pabwlc/memristive-dual-agent-circuit/analog_signal_processing_board_pcb_layout_bom.pdf

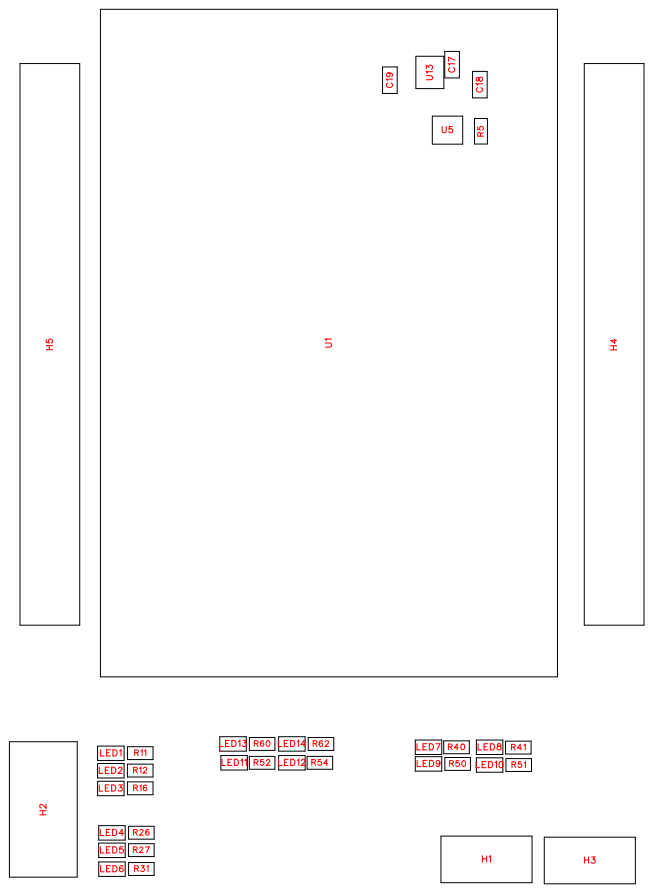
[picture p1: page 1]

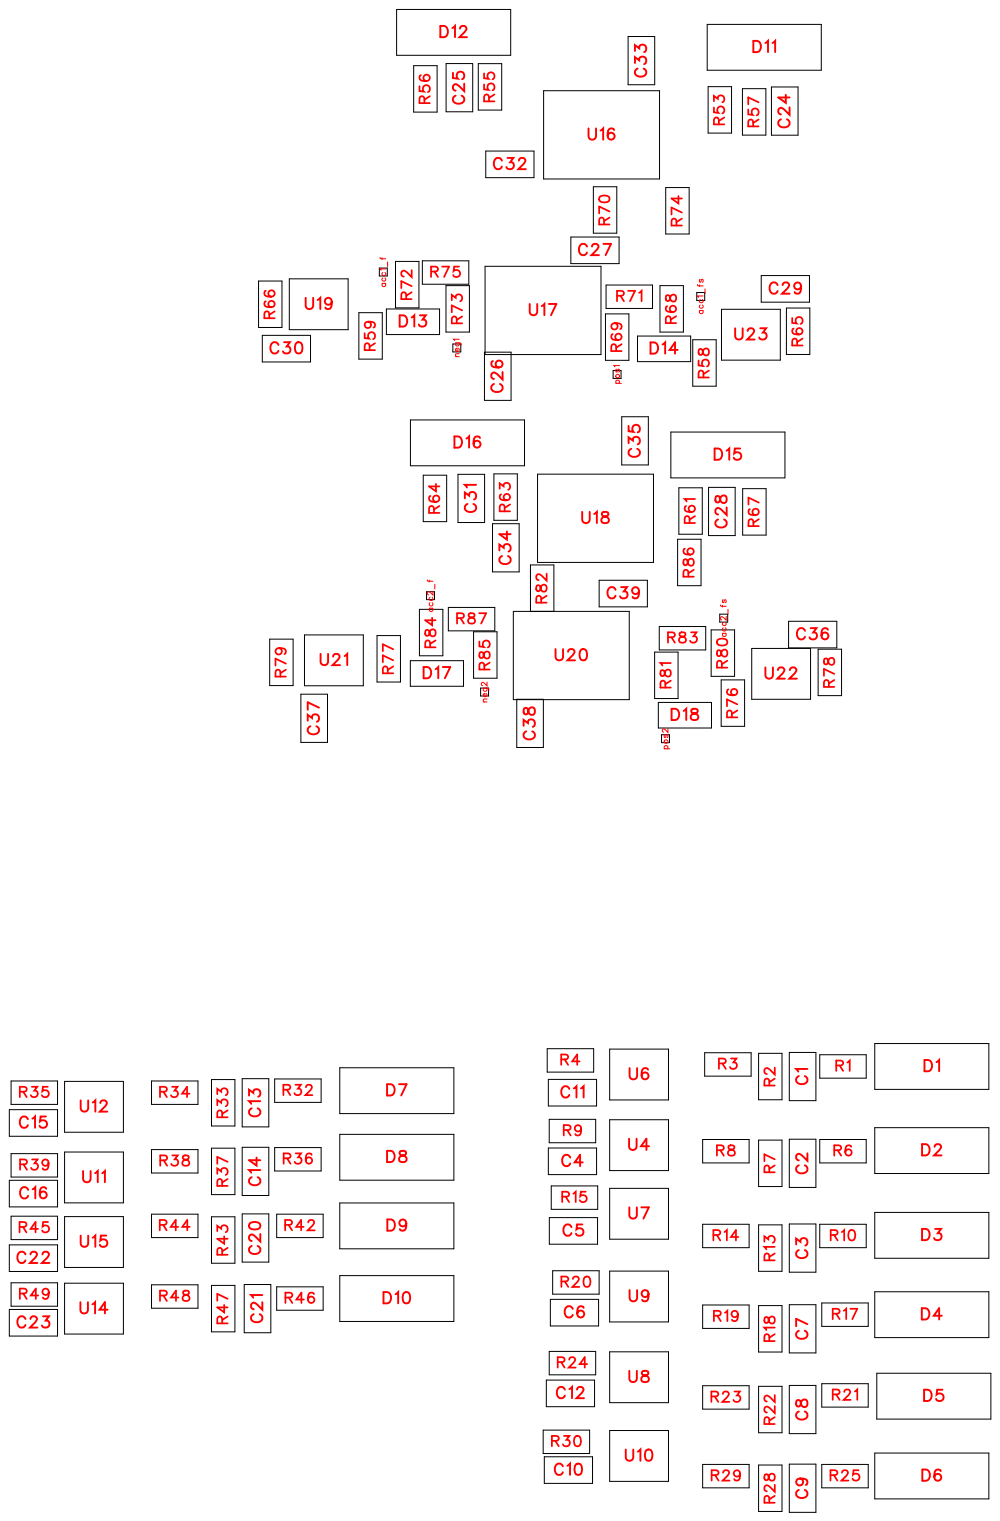
[picture p2: page 2]

No. | Quantity | Comment | Designator | Footprint | Value | Manufacturer Part | Manufacturer | Supplier Part | Supplier
1 | 8 | Test-Point | acc1_f,acc1_fs,acc2_f,acc2 _fs,neg1,neg2,pos1,pos2 | Test-Point-0. 5mm
2 | 10 | 220nF | C1,C2,C3,C7,C8,C9,C13,C 14,C20,C21 | C0603 | 220nF
3 | 14 | 0.1uf | C4,C5,C6,C10,C11,C12,C1 5,C16,C22,C23,C29,C30,C 36,C37 | C0603 | 0.1uf
4 | 3 | 1uf | C17,C18,C19 | C0603 | 1uf
5 | 4 | 470nf | C24,C25,C28,C31 | C0603 | 470nf
6 | 8 | 100nF | C26,C27,C32,C33,C34,C35 ,C38,C39 | C0603 | 100nF
7 | 14 | D_1N4007 | D1,D2,D3,D4,D5,D6,D7,D8, D9,D10,D11,D12,D15,D16 | SMA_1N400 7
8 | 4 | CUS10S30,H 3F | D13,D14,D17,D18 | SOD-323_L1 .8-W1.3-LS2. 5-RD | | CUS10S30,H 3F | TOSHIBA(东 芝) | C146335 | LCSC
9 | 2 | PZ254V-12-8 P | H1,H3 | HDR-TH_8P-P2.54-V-M-R 2-C4-S2.54 | | PZ254V-12-8 P | XFCN(兴飞) | C492421 | LCSC
10 | 1 | HX PZ2.54-3x6P ZZ | H2 | CONN-TH_H X-PZ2.54-3X 6P-ZZ | | HX PZ2.54-3x6P ZZ | hanxia(韩下) | C32713293 | LCSC
11 | 2 | HC-PM254-8 .5H-2x25PZ | H4,H5 | HDR-TH_50 P-P2.54-V-F-R2-C25-S2.5 4-1 | | HC-PM254-8 .5H-2x25PZ | HC(虹成电子 ) | C27985240 | LCSC
12 | 14 | LED_0603-R | LED1,LED2,LED3,LED4,LE D5,LED6,LED7,LED8,LED9 ,LED10,LED11,LED12,LED 13,LED14 | LED_0603
13 | 20 | 47K | R1,R4,R6,R9,R10,R15,R17, R20,R21,R24,R25,R30,R32 ,R35,R36,R39,R42,R45,R4 6,R49 | R0603 | 47K
14 | 10 | 1000K | R2,R7,R13,R18,R22,R28,R 33,R37,R43,R47 | R0603 | 1000K
15 | 31 | 10K | R3,R5,R8,R14,R19,R23,R2 9,R34,R38,R44,R48,R58,R 59,R68,R69,R70,R71,R72, R73,R74,R75,R76,R77,R80 ,R81,R82,R83,R84,R85,R8 6,R87 | R0603 | 10K
16 | 10 | 1K | R11,R12,R16,R26,R27,R31 ,R40,R41,R50,R51 | R0603 | 1K
17 | 4 | 1k | R52,R54,R60,R62 | R0603 | 1k
18 | 8 | 47k | R53,R55,R61,R63,R65,R66 ,R78,R79 | R0603 | 47k
19 | 4 | 1000k | R56,R57,R64,R67 | R0603 | 1000k

20 | 1 | 野火FPGA | U1 | 野火FPGA
21 | 14 | TL331IDBVR | U4,U6,U7,U8,U9,U10,U11, U12,U14,U15,U19,U21,U22 ,U23 | SOT-23-5_L3 .0-W1.7-P0.9 5-LS2.8-BR | TL331IDBVR | TI(德州仪器 ) | C80942 | LCSC
22 | 1 | LM285M3X-1 .2 | U5 | SOT-23-3_L2 .9-W1.3-P1.9 0-LS2.4 | LM285M3X-1 .2 | | C990000629 0 | LCSC
23 | 1 | TPS60403D BVR | U13 | SOT-23-5_L3 .0-W1.7-P0.9 5-LS2.8-BR | TPS60403D BVR | TI(德州仪器 ) | C11338 | LCSC
24 | 4 | TLV2372IDR | U16,U17,U18,U20 | SOIC-8_L4.9 -W3.9-P1.27-LS6.0-BL | TLV2372IDR | TI(德州仪器 ) | C27204 | LCSC

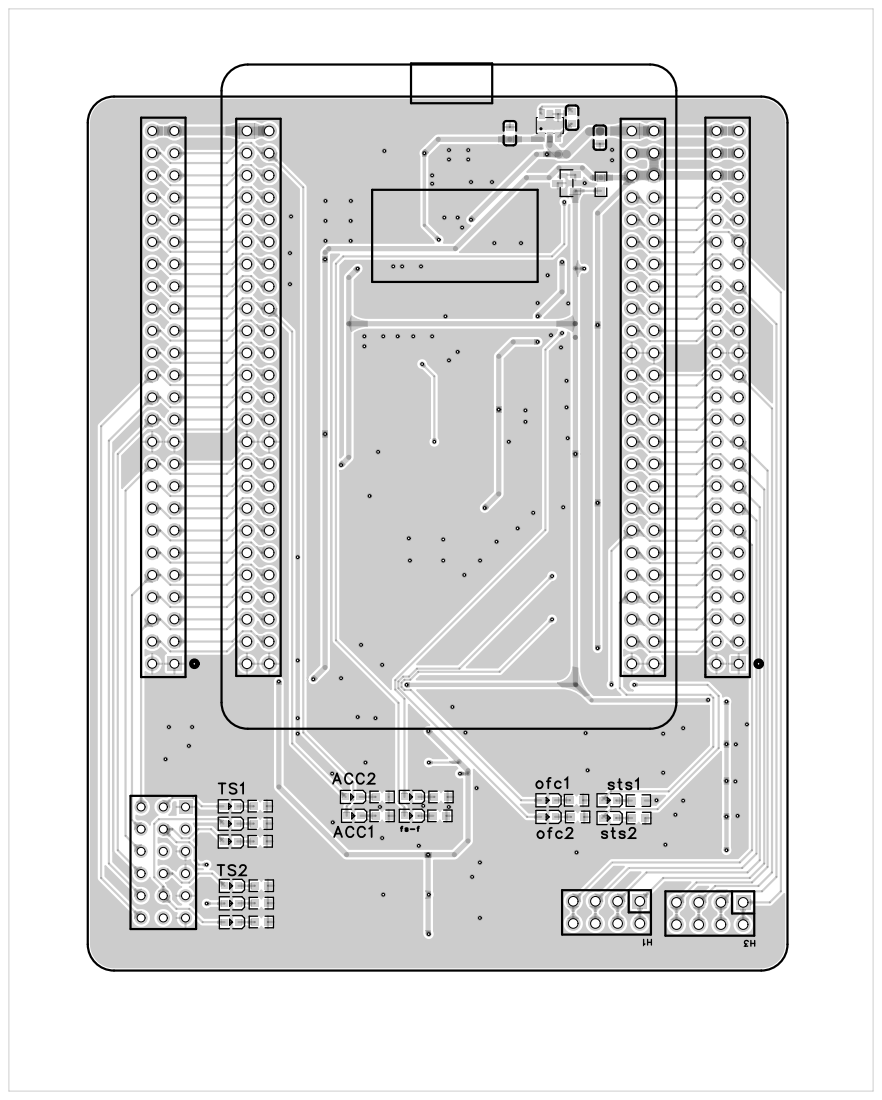
[picture p3: page 5]

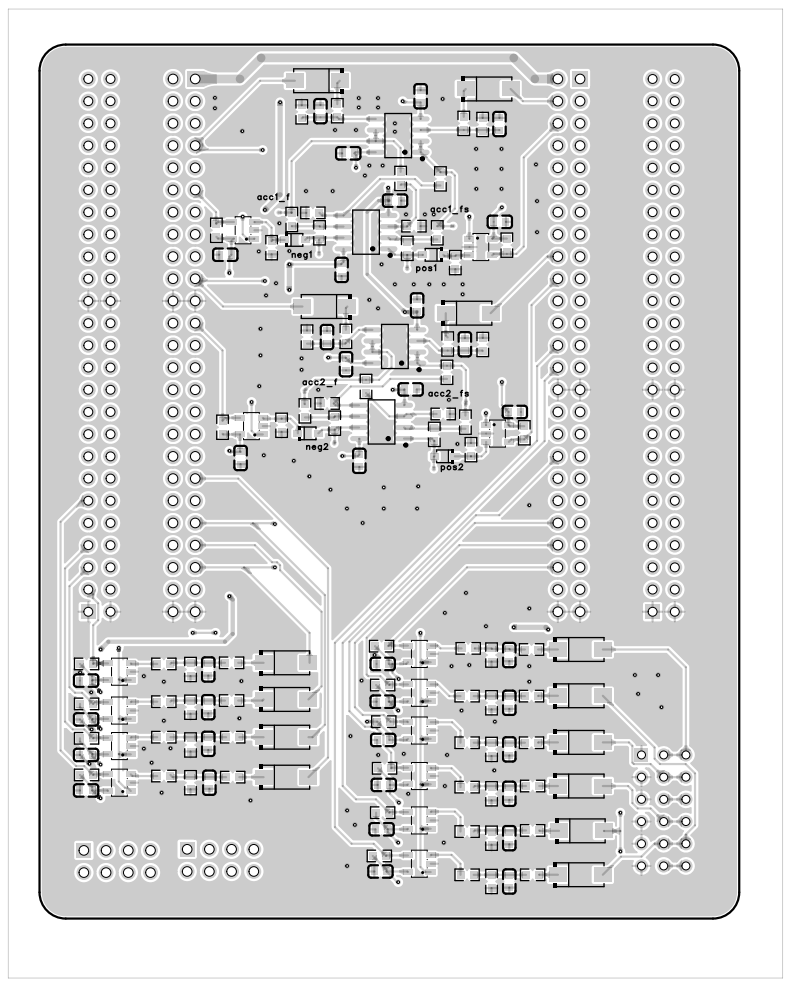
[picture p4: page 6]

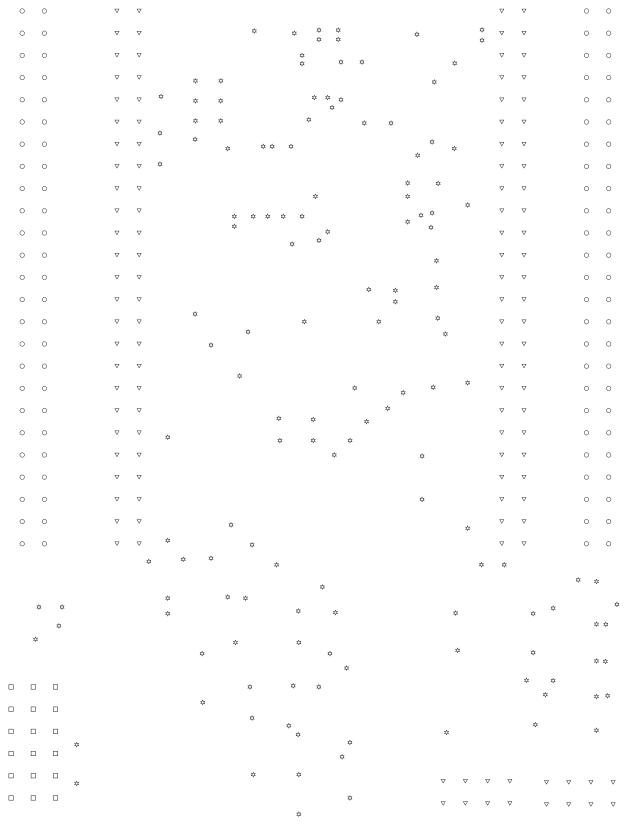
[picture p5: page 7]
