pabwlc/memristive-dual-agent-circuit/analog_signal_processing_board_schematic.pdf

# 野火FPGA

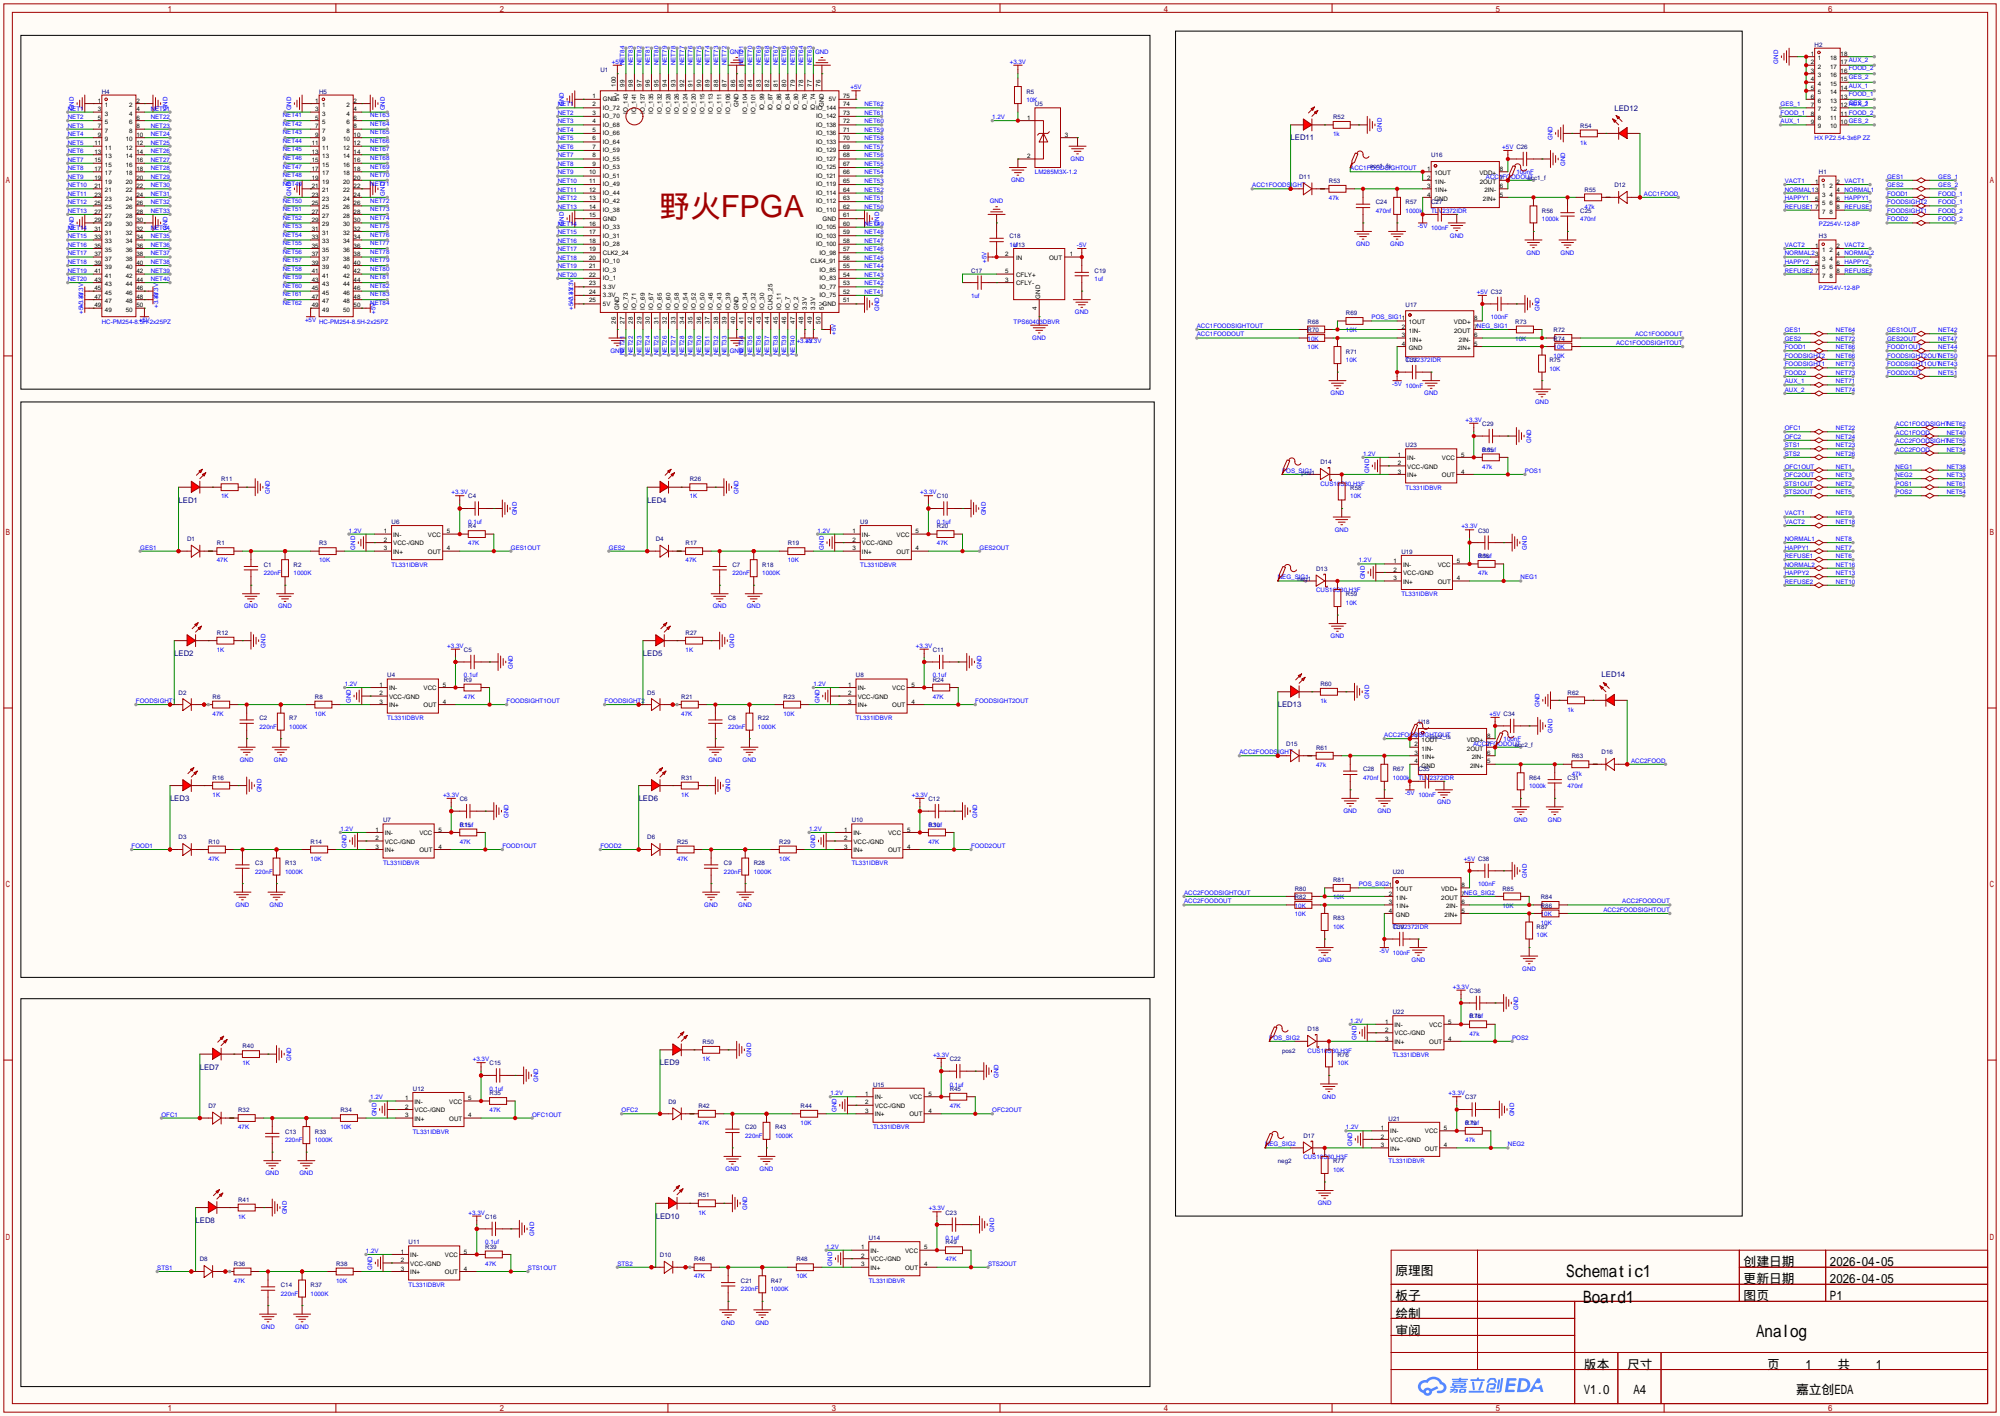
[picture p6: page 1]

更新日期 | 2026-04-05

板子 | Board1 | 图页 | P1
绘制 | | Analog
审阅

V1.0 | A4 | 嘉立创EDA
